rolandkohn/attiny-isp-breadboard/(commit log)

2026-10-26 README: warn about breadboard rail polarity
2026-10-26 Docs: rail polarity warning and part alternatives
